xdylanm/sequencer-1/README.md

# Sequencer One

An open step sequencer platform.
