xdylanm/sequencer-1/docs/assets/images/timing_adjust_speed.pdf

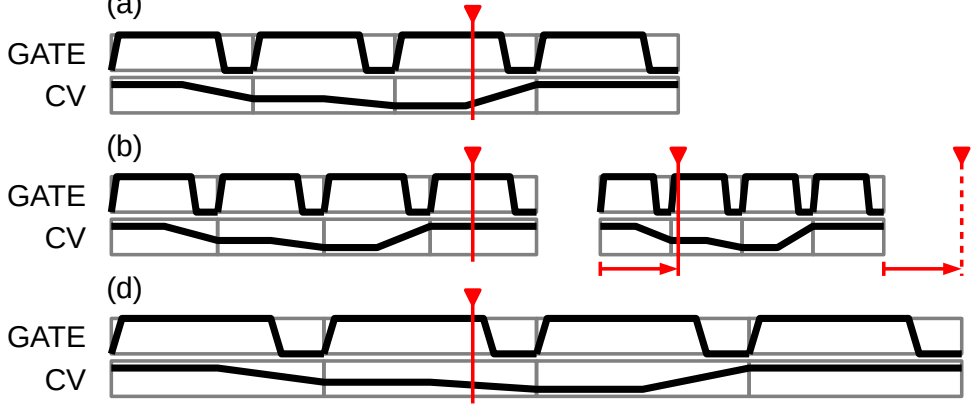
[picture p3: figure]
GATE

(a)
