xdylanm/sequencer-1/docs/assets/images/bpm_status.png

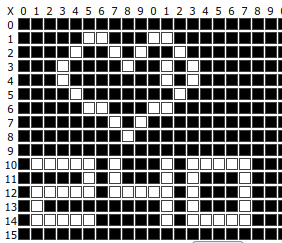
docs/assets/images/bpm_status.png
