xdylanm/sequencer-1/docs/assets/images/duty_status.png

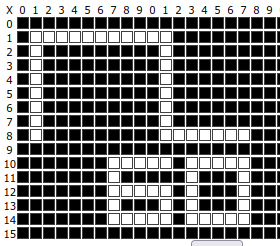
docs/assets/images/duty_status.png
