xdylanm/sequencer-1/docs/assets/images/loop_pattern.png

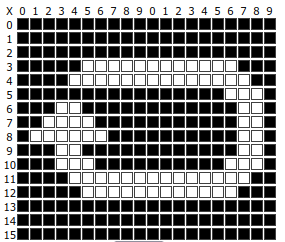
docs/assets/images/loop_pattern.png
