xdylanm/sequencer-1/docs/assets/images/pattern_quant_voct_status.png

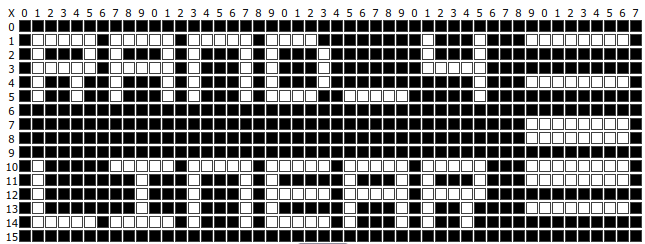
docs/assets/images/pattern_quant_voct_status.png
