xdylanm/sequencer-1/docs/assets/images/SAMD21E_AD_conversion_timing.png

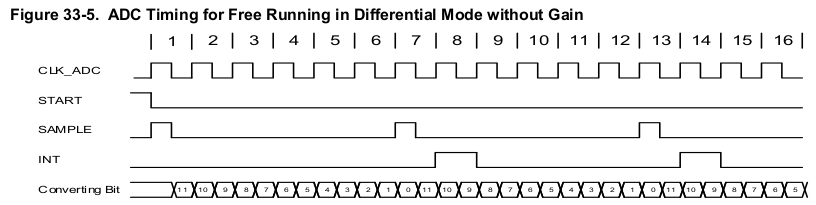
docs/assets/images/SAMD21E_AD_conversion_timing.png
