xdylanm/sequencer-1/docs/assets/images/slide_status.png

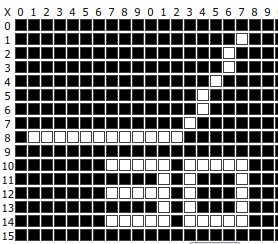
docs/assets/images/slide_status.png
