xdylanm/sequencer-1/docs/assets/images/timing_ADC_conv.png

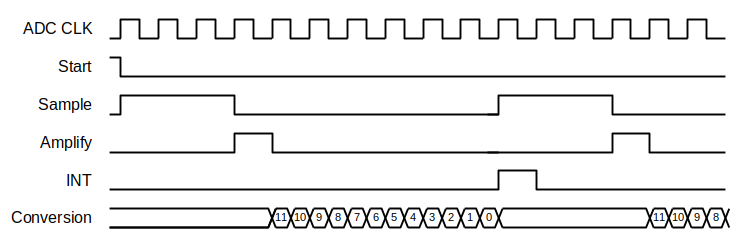
docs/assets/images/timing_ADC_conv.png
