xdylanm/sequencer-1/docs/assembly.md

# Assembly Guide

Step by step instructions for assembly

## BOM

[Download (.csv)](assets/bom.csv)

{%include-markdown "assets/bom.md"%}
