xdylanm/sequencer-1/(threads)

Thread 1 (2024-03-02):

Initial menu design

xdylanm, 2024-03-02:
Design the initial menu to control the sequencer.

- Input: rotary control with push button action
- Display: split 0.96" 128x64 OLED
  - 16 px top for status
  - 48 px bottom for menu/action
- Control
  - speed (BPM): 20-200
  - duty (%): 0-100
  - slide (%): 0-100
  - quantization: linear (none), minor, major, chromatic
  - activate: select on/off by key
    - would be preferred to have a mode button here to activate "buttons mean on/off"
  - mode: loop, bounce, random, piano
    - would be nice to have a start/stop button that could press & hold to set the current interval with a note button
  - sequence length: 1-8

xdylanm, 2024-07-13:
Done

Closed 2024-07-13.

Thread 2 (2024-03-18):

Implement core loop timing

xdylanm, 2024-03-18:
Based on the ADC conversion time (see design document for details), interleave analog mux increments and ADC reads

If read cycle
1. record level from ADC
2. record button state (debounce logic)
else
1. advance MUX address

Then
1. trigger a DA conversion
2. write GATE out
3. increment interval counter
4. calculate next state
5. update displays
6. check rotary input

xdylanm, 2024-07-13:
Done

Closed 2024-07-13.
