xdylanm/sequencer-1/hardware/seq1/seq1.kicad_pcb

## KiCad design hardware/seq1/seq1.kicad_pcb (2026-07-25)

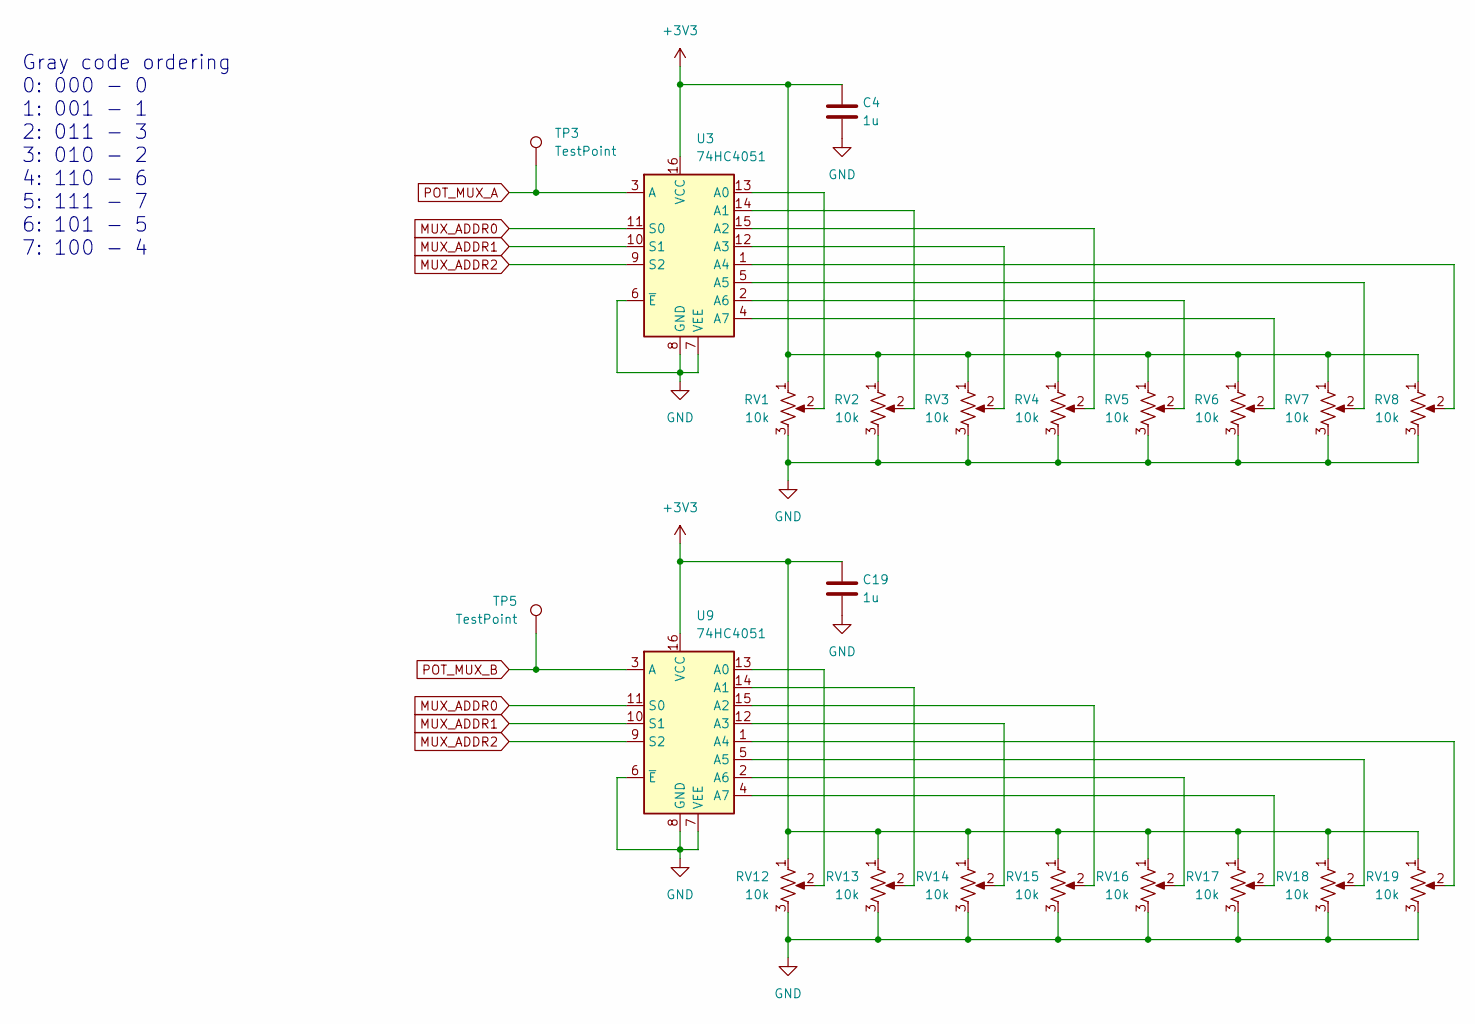
[picture p13: schematic muxdinputs.kicad_sch, Sequencer]

Parts:
C4, C19: 1u; C_Disc_D5.0mm_W2.5mm_P2.50mm
RV1, RV2, RV3, RV4, RV5, RV6, RV7, RV8, RV12, RV13, RV14, RV15, RV16, RV17, RV18, RV19: 10k; Potentiometer_Bourns_PTV09A-1_Single_Vertical
TP3, TP5: TestPoint; PinHeader_1x01_P2.54mm_Vertical
U3, U9: 74HC4051; DIP-16_W7.62mm_Socket

Connections:
+3V3: C4.1, C19.1, RV1.1, RV2.1, RV3.1, RV4.1, RV5.1, RV6.1, RV7.1, RV8.1, RV12.1, RV13.1, RV14.1, RV15.1, RV16.1, RV17.1, RV18.1, RV19.1, U3.16 (VCC), U9.16 (VCC); also elsewhere on the board
GND: C4.2, C19.2, RV1.3, RV2.3, RV3.3, RV4.3, RV5.3, RV6.3, RV7.3, RV8.3, RV12.3, RV13.3, RV14.3, RV15.3, RV16.3, RV17.3, RV18.3, RV19.3, U3.6 (~E), U3.7 (VEE), U3.8 (GND), U9.6 (~E), U9.7 (VEE), U9.8 (GND); also elsewhere on the board
MUX_ADDR0: U3.11 (S0), U9.11 (S0); also elsewhere on the board
MUX_ADDR1: U3.10 (S1), U9.10 (S1); also elsewhere on the board
MUX_ADDR2: U3.9 (S2), U9.9 (S2); also elsewhere on the board
unnamed: RV1.2, U3.13 (A0)
unnamed: RV2.2, U3.14 (A1)
unnamed: RV4.2, U3.15 (A2)
unnamed: RV3.2, U3.12 (A3)
unnamed: RV8.2, U3.1 (A4)
unnamed: RV7.2, U3.5 (A5)
unnamed: RV5.2, U3.2 (A6)
unnamed: RV6.2, U3.4 (A7)
unnamed: RV12.2, U9.13 (A0)
unnamed: RV13.2, U9.14 (A1)
unnamed: RV15.2, U9.15 (A2)
unnamed: RV14.2, U9.12 (A3)
unnamed: RV19.2, U9.1 (A4)
unnamed: RV18.2, U9.5 (A5)
unnamed: RV16.2, U9.2 (A6)
unnamed: RV17.2, U9.4 (A7)
POT_MUX_A: TP3.1, U3.3 (A); also elsewhere on the board
POT_MUX_B: TP5.1, U9.3 (A); also elsewhere on the board

Notes on the sheet:
Gray code ordering 0: 000 - 0 1: 001 - 1 2: 011 - 3 3: 010 - 2 4: 110 - 6 5: 111 - 7 6: 101 - 5 7: 100 - 4

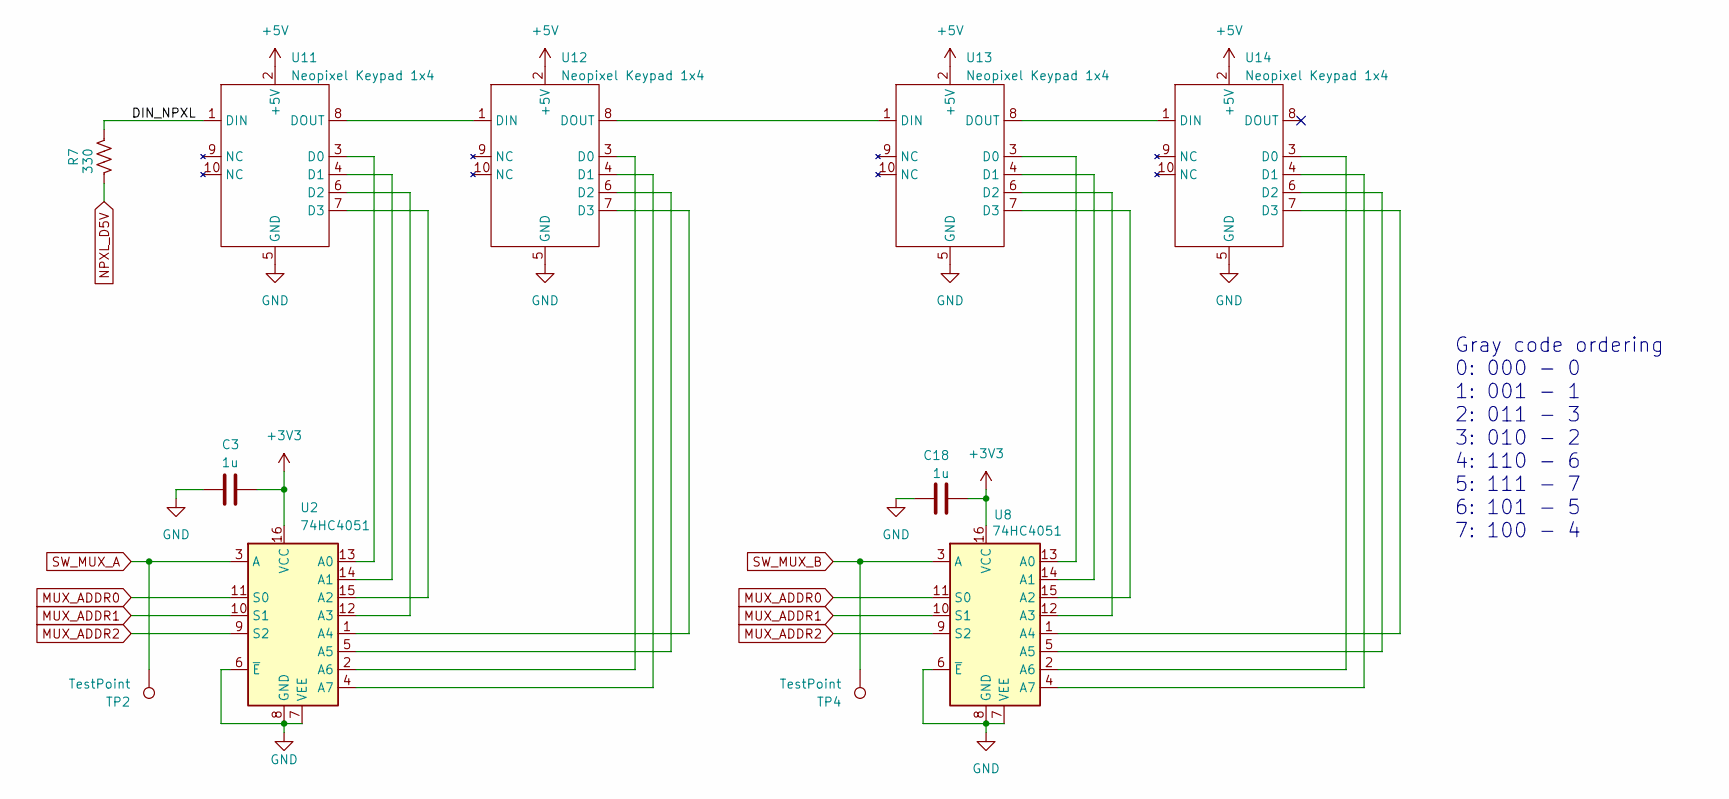
[picture p14: schematic neopxls.kicad_sch, Sequencer]

Parts:
C3, C18: 1u; C_Disc_D5.0mm_W2.5mm_P2.50mm
R7: 330; R_Axial_DIN0204_L3.6mm_D1.6mm_P2.54mm_Vertical
TP2, TP4: TestPoint; PinHeader_1x01_P2.54mm_Vertical
U2, U8: 74HC4051; DIP-16_W7.62mm_Socket
U11, U12, U13, U14: Neopixel Keypad 1x4; SW_Keypad_PushButton_1x4_Riser

Connections:
+3V3: C3.1, C18.2, U2.16 (VCC), U8.16 (VCC); also elsewhere on the board
+5V: U11.2 (+5V), U12.2 (+5V), U13.2 (+5V), U14.2 (+5V); also elsewhere on the board
/neopxls/DIN_NPXL: R7.2, U11.1 (DIN)
GND: C3.2, C18.1, U2.6 (~E), U2.7 (VEE), U2.8 (GND), U8.6 (~E), U8.7 (VEE), U8.8 (GND), U11.5 (GND), U12.5 (GND), U13.5 (GND), U14.5 (GND); also elsewhere on the board
MUX_ADDR0: U2.11 (S0), U8.11 (S0); also elsewhere on the board
MUX_ADDR1: U2.10 (S1), U8.10 (S1); also elsewhere on the board
MUX_ADDR2: U2.9 (S2), U8.9 (S2); also elsewhere on the board
NPXL_D5V: R7.1; also elsewhere on the board
unnamed: U2.13 (A0), U11.3 (D0)
unnamed: U2.14 (A1), U11.4 (D1)
unnamed: U2.12 (A3), U11.6 (D2)
unnamed: U2.15 (A2), U11.7 (D3)
unnamed: U11.8 (DOUT), U12.1 (DIN)
unnamed: U2.2 (A6), U12.3 (D0)
unnamed: U2.4 (A7), U12.4 (D1)
unnamed: U2.5 (A5), U12.6 (D2)
unnamed: U2.1 (A4), U12.7 (D3)
unnamed: U12.8 (DOUT), U13.1 (DIN)
unnamed: U8.13 (A0), U13.3 (D0)
unnamed: U8.14 (A1), U13.4 (D1)
unnamed: U8.12 (A3), U13.6 (D2)
unnamed: U8.15 (A2), U13.7 (D3)
unnamed: U13.8 (DOUT), U14.1 (DIN)
unnamed: U8.2 (A6), U14.3 (D0)
unnamed: U8.4 (A7), U14.4 (D1)
unnamed: U8.5 (A5), U14.6 (D2)
unnamed: U8.1 (A4), U14.7 (D3)
SW_MUX_A: TP2.1, U2.3 (A); also elsewhere on the board
SW_MUX_B: TP4.1, U8.3 (A); also elsewhere on the board

Notes on the sheet:
Gray code ordering 0: 000 - 0 1: 001 - 1 2: 011 - 3 3: 010 - 2 4: 110 - 6 5: 111 - 7 6: 101 - 5 7: 100 - 4

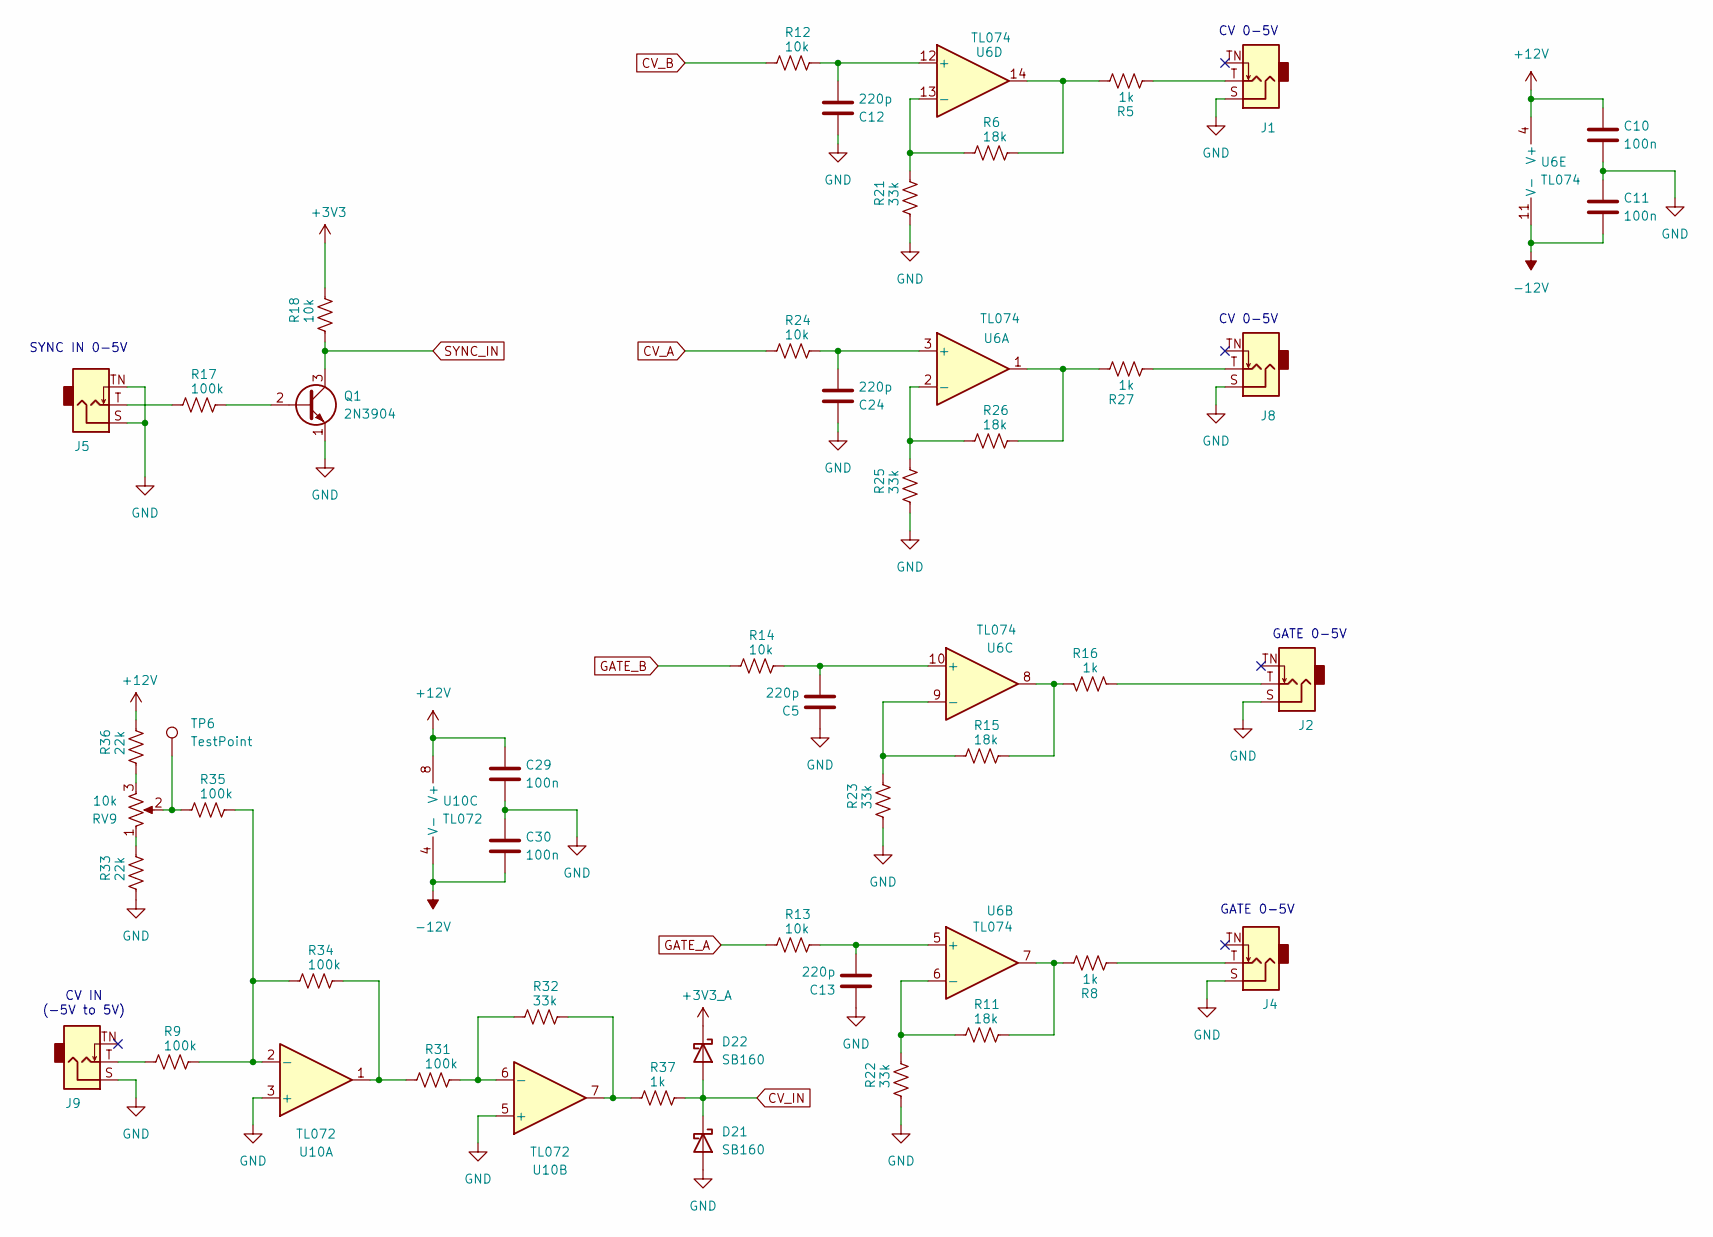
[picture p15: schematic outputs.kicad_sch, Sequencer]

Parts:
C5, C12, C13, C24: 220p; C_Disc_D5.0mm_W2.5mm_P2.50mm
C10, C11, C29, C30: 100n; C_Disc_D5.0mm_W2.5mm_P2.50mm
D21, D22: SB160; D_DO-35_SOD27_P2.54mm_Vertical_AnodeUp
J1, J2, J4, J5, J8, J9: AudioJack2_SwitchT; Jack_3.5mm_QingPu_WQP-PJ301M-12_Vertical
Q1: 2N3904; TO-92_Inline_Wide
R5, R8, R16, R37: 1k; R_Axial_DIN0204_L3.6mm_D1.6mm_P2.54mm_Vertical
R6, R11, R15, R26: 18k; R_Axial_DIN0204_L3.6mm_D1.6mm_P2.54mm_Vertical
R9, R17, R34, R35: 100k; R_Axial_DIN0204_L3.6mm_D1.6mm_P2.54mm_Vertical
R12, R18, R24: 10k; R_Axial_DIN0204_L3.6mm_D1.6mm_P2.54mm_Vertical
R13, R14: 10k; R_Axial_DIN0207_L6.3mm_D2.5mm_P10.16mm_Horizontal
R21, R22, R23, R25, R32: 33k; R_Axial_DIN0204_L3.6mm_D1.6mm_P2.54mm_Vertical
R27: 1k; R_Axial_DIN0204_L3.6mm_D1.6mm_P7.62mm_Horizontal
R31: 100k; R_Axial_DIN0204_L3.6mm_D1.6mm_P7.62mm_Horizontal
R33, R36: 22k; R_Axial_DIN0204_L3.6mm_D1.6mm_P2.54mm_Vertical
RV9: 10k; Potentiometer_Piher_PT-6-V_Vertical
TP6: TestPoint; PinHeader_1x01_P2.54mm_Vertical
U6: TL074; DIP-14_W7.62mm_Socket
U10: TL072; DIP-8_W7.62mm_Socket

Connections:
+3V3: R18.1; also elsewhere on the board
+3V3_A: D22.1 (K); also elsewhere on the board
+12V: C10.1, C29.1, R36.1, U6.4 (V+), U10.8 (V+); also elsewhere on the board
-12V: C11.2, C30.2, U6.11 (V-), U10.4 (V-); also elsewhere on the board
CV_A: R24.2; also elsewhere on the board
CV_B: R12.2; also elsewhere on the board
CV_IN: D21.1 (K), D22.2 (A), R37.1; also elsewhere on the board
GATE_A: R13.2; also elsewhere on the board
GATE_B: R14.2; also elsewhere on the board
GND: C5.1, C10.2, C11.1, C12.1, C13.1, C24.1, C29.2, C30.1, D21.2 (A), J1.S, J2.S, J4.S, J5.S, J5.TN, J8.S, J9.S, Q1.1 (E), R21.2, R22.2, R23.2, R25.2, R33.2, U10.3 (+), U10.5 (+); also elsewhere on the board
unnamed: J1.T, R5.2
unnamed: J2.T, R16.2
unnamed: J4.T, R8.2
unnamed: J5.T, R17.2
unnamed: J8.T, R27.2
unnamed: J9.T, R9.2
unnamed: Q1.2 (B), R17.1
unnamed: R5.1, R6.1, U6.14
unnamed: R8.1, R11.1, U6.7
unnamed: R15.1, R16.1, U6.8
unnamed: R26.1, R27.1, U6.1
unnamed: R31.2, R34.1, U10.1
unnamed: R32.1, R37.2, U10.7
unnamed: R33.1, RV9.1
unnamed: R35.2, RV9.2, TP6.1
unnamed: R36.2, RV9.3
unnamed: C24.2, R24.1, U6.3 (+)
unnamed: R25.1, R26.2, U6.2 (-)
unnamed: C13.2, R13.1, U6.5 (+)
unnamed: R11.2, R22.1, U6.6 (-)
unnamed: C5.2, R14.1, U6.10 (+)
unnamed: R15.2, R23.1, U6.9 (-)
unnamed: C12.2, R12.1, U6.12 (+)
unnamed: R6.2, R21.1, U6.13 (-)
unnamed: R9.1, R34.2, R35.1, U10.2 (-)
unnamed: R31.1, R32.2, U10.6 (-)
SYNC_IN: Q1.3 (C), R18.2; also elsewhere on the board

Notes on the sheet:
SYNC IN 0-5V
CV IN (-5V to 5V)
GATE 0-5V
CV 0-5V

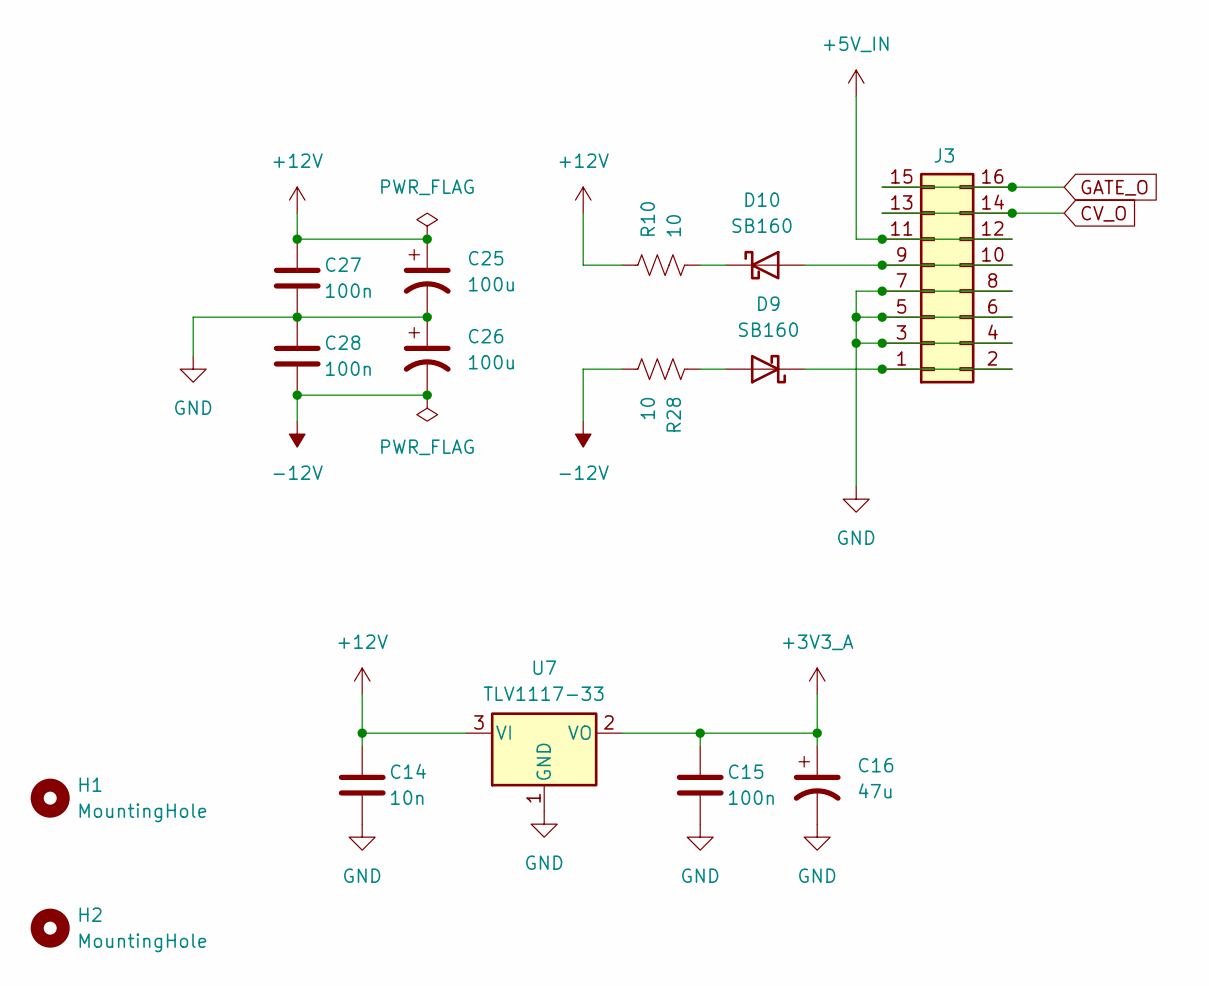
[picture p16: schematic pwr.kicad_sch, Sequencer]

Parts:
C14: 10n; C_Disc_D5.0mm_W2.5mm_P2.50mm
C15, C27, C28: 100n; C_Disc_D5.0mm_W2.5mm_P2.50mm
C16: 47u; CP_Radial_D5.0mm_P2.50mm
C25, C26: 100u; CP_Radial_D6.3mm_P2.50mm
D9, D10: SB160; D_DO-35_SOD27_P2.54mm_Vertical_AnodeUp
H1, H2: MountingHole; MountingHole_3.2mm_M3_DIN965
J3: Conn_02x08_Odd_Even; IDC-Header_2x08_P2.54mm_Vertical
R10: 10; R_Axial_DIN0204_L3.6mm_D1.6mm_P2.54mm_Vertical
R28: 10; R_Axial_DIN0207_L6.3mm_D2.5mm_P7.62mm_Horizontal
U7: TLV1117-33; SOT-223-3_TabPin2

Connections:
+3V3_A: C15.1, C16.1, U7.2 (VO); also elsewhere on the board
+5V_IN: J3.11, J3.12; also elsewhere on the board
+12V: C14.1, C25.1, C27.1, R10.1, U7.3 (VI); also elsewhere on the board
-12V: C26.2, C28.2, R28.2; also elsewhere on the board
CV_O: J3.13, J3.14
GATE_O: J3.15, J3.16
GND: C14.2, C15.2, C16.2, C25.2, C26.1, C27.2, C28.1, J3.3, J3.4, J3.5, J3.6, J3.7, J3.8, U7.1 (GND); also elsewhere on the board
unnamed: D9.2 (A), R28.1
unnamed: D9.1 (K), J3.1, J3.2
unnamed: D10.2 (A), J3.9, J3.10
unnamed: D10.1 (K), R10.2

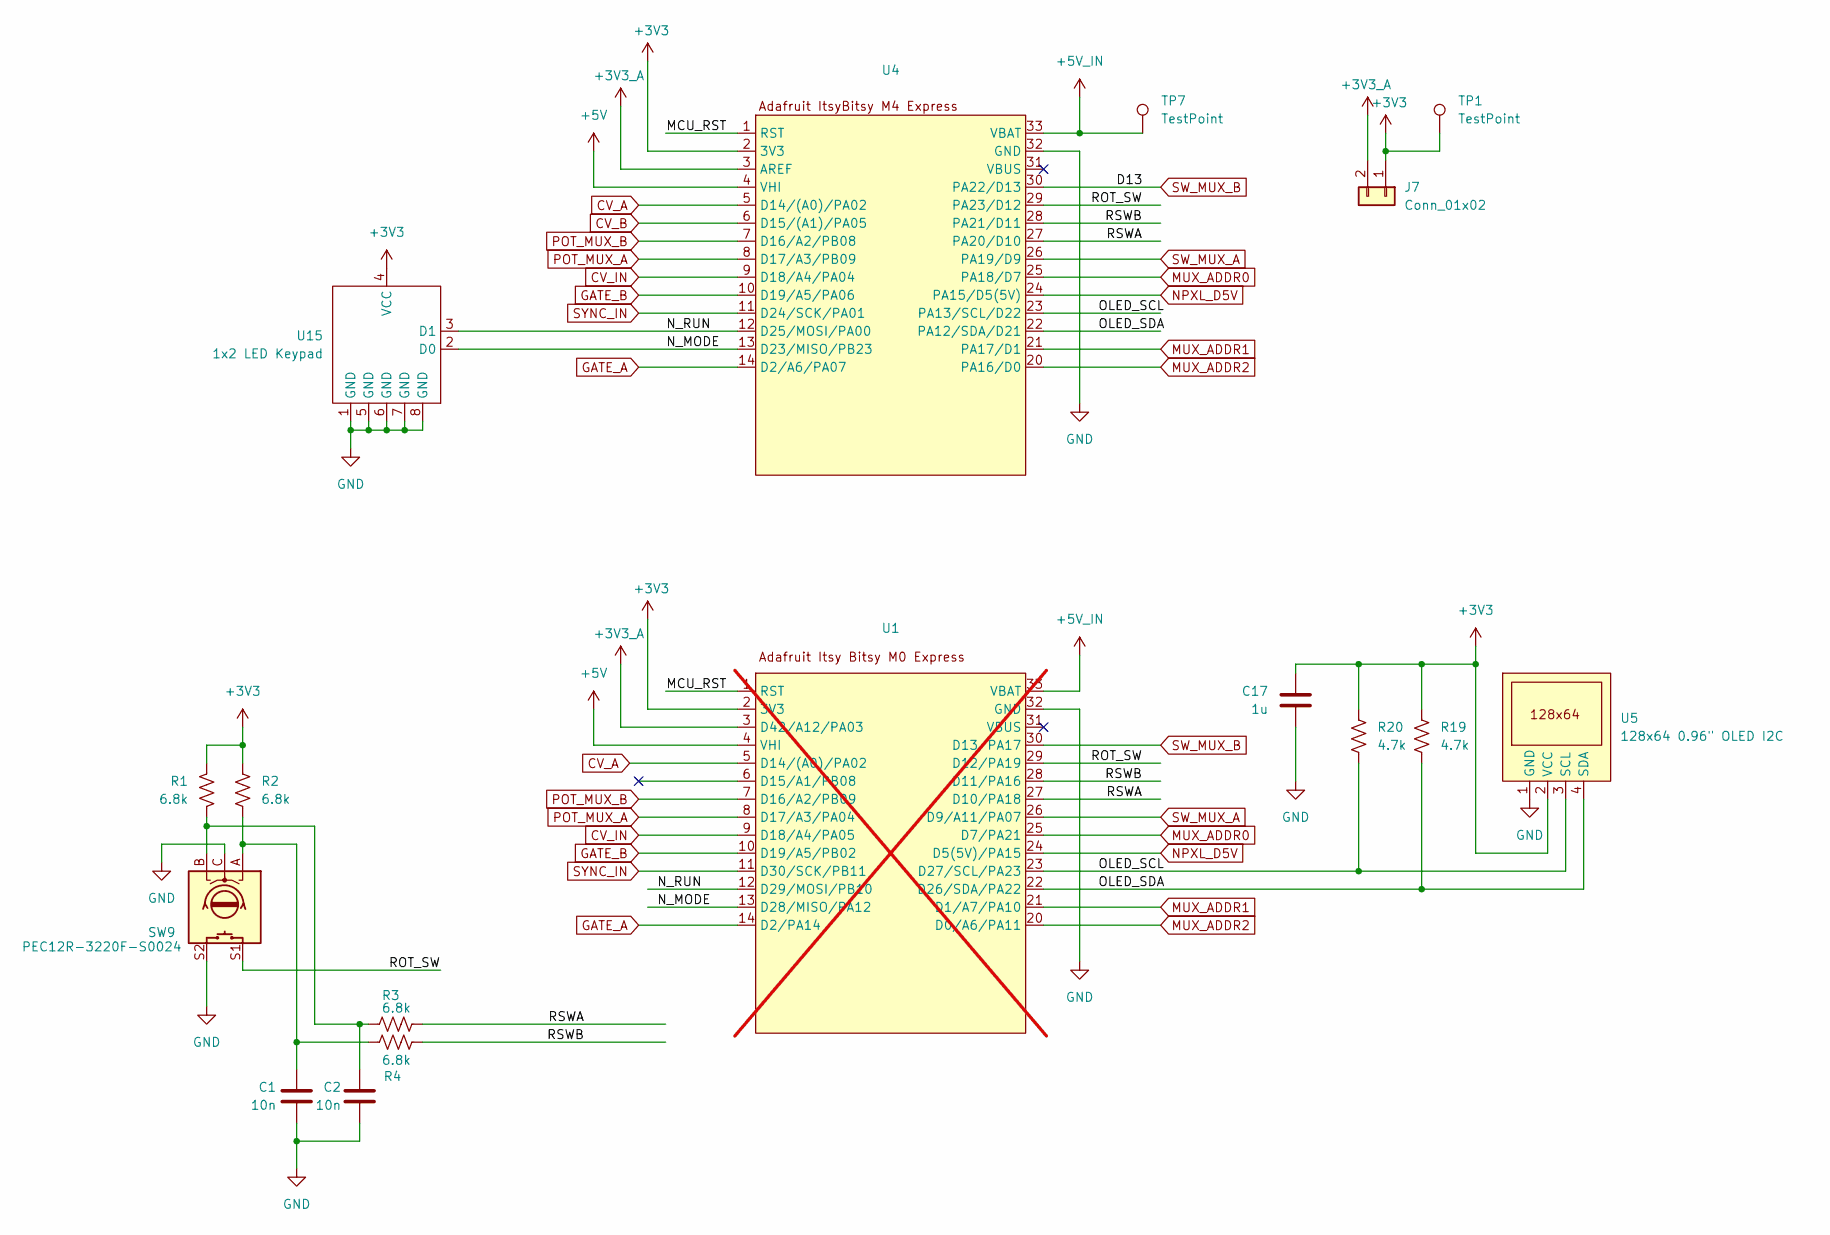
[picture p17: schematic mcu.kicad_sch, Sequencer]

Parts:
C1, C2: 10n; C_Disc_D5.0mm_W2.5mm_P2.50mm
C17: 1u; C_Disc_D5.0mm_W2.5mm_P2.50mm
J7: Conn_01x02; PinHeader_1x02_P2.54mm_Vertical
R1, R2, R3, R4: 6.8k; R_Axial_DIN0204_L3.6mm_D1.6mm_P2.54mm_Vertical
R19, R20: 4.7k; R_Axial_DIN0204_L3.6mm_D1.6mm_P2.54mm_Vertical
SW9: PEC12R-3220F-S0024; RotaryEncoder_Bourns_Vertical_PEC12R-3x17F-Sxxxx
TP1, TP7: TestPoint; PinHeader_1x01_P2.54mm_Vertical
U1: Adafruit_ItsyBitsy_M0_Express_DIP; not fitted
U4: Adafruit_ItsyBitsy_M0_Express_DIP
U5: 128x64 0.96" OLED I2C; OLED_0.96in_SSD1306_I2C
U15: 1x2 LED Keypad; SW_Keypad_PushButton_1x2_Riser

Connections:
+3V3: C17.1, J7.1, R1.1, R2.1, R19.1, R20.1, TP1.1, U1.2 (3V3), U4.2 (3V3), U5.2 (VCC), U15.4 (VCC); also elsewhere on the board
+3V3_A: J7.2, U1.3 (D42/A12/PA03), U4.3 (AREF); also elsewhere on the board
+5V: U1.4 (VHI), U4.4 (VHI); also elsewhere on the board
+5V_IN: TP7.1, U1.33 (VBAT), U4.33 (VBAT); also elsewhere on the board
/mcu/MCU_RST: U1.1 (RST), U4.1 (RST)
/mcu/N_MODE: U1.13 (D28/MISO/PA12), U4.13 (D23/MISO/PB23), U15.2 (D0)
/mcu/N_RUN: U1.12 (D29/MOSI/PB10), U4.12 (D25/MOSI/PA00), U15.3 (D1)
/mcu/OLED_SCL: R20.2, U1.23 (D27/SCL/PA23), U4.23 (PA13/SCL/D22), U5.3 (SCL)
/mcu/OLED_SDA: R19.2, U1.22 (D26/SDA/PA22), U4.22 (PA12/SDA/D21), U5.4 (SDA)
/mcu/ROT_SW: SW9.S1, U1.29 (D12/PA19), U4.29 (PA23/D12)
/mcu/RSWA: R3.1, U1.27 (D10/PA18), U4.27 (PA20/D10)
/mcu/RSWB: R4.1, U1.28 (D11/PA16), U4.28 (PA21/D11)
CV_A: U1.5 (D14/(A0)/PA02), U4.5 (D14/(A0)/PA02); also elsewhere on the board
CV_B: U4.6 (D15/(A1)/PA05); also elsewhere on the board
CV_IN: U1.9 (D18/A4/PA05), U4.9 (D18/A4/PA04); also elsewhere on the board
GATE_A: U1.14 (D2/PA14), U4.14 (D2/A6/PA07); also elsewhere on the board
GATE_B: U1.10 (D19/A5/PB02), U4.10 (D19/A5/PA06); also elsewhere on the board
GND: C1.2, C2.2, C17.2, SW9.C, SW9.S2, U1.32 (GND), U4.32 (GND), U5.1 (GND), U15.1 (GND), U15.5 (GND), U15.6 (GND), U15.7 (GND), U15.8 (GND); also elsewhere on the board
MUX_ADDR0: U1.25 (D7/PA21), U4.25 (PA18/D7); also elsewhere on the board
MUX_ADDR1: U1.21 (D1/A7/PA10), U4.21 (PA17/D1); also elsewhere on the board
MUX_ADDR2: U1.20 (D0/A6/PA11), U4.20 (PA16/D0); also elsewhere on the board
NPXL_D5V: U1.24 (D5(5V)/PA15), U4.24 (PA15/D5(5V)); also elsewhere on the board
unnamed: C1.1, R2.2, R4.2, SW9.A
unnamed: C2.1, R1.2, R3.2, SW9.B
POT_MUX_A: U1.8 (D17/A3/PA04), U4.8 (D17/A3/PB09); also elsewhere on the board
POT_MUX_B: U1.7 (D16/A2/PB09), U4.7 (D16/A2/PB08); also elsewhere on the board
SW_MUX_A: U1.26 (D9/A11/PA07), U4.26 (PA19/D9); also elsewhere on the board
SW_MUX_B: U1.30 (D13/PA17), U4.30 (PA22/D13); also elsewhere on the board
SYNC_IN: U1.11 (D30/SCK/PB11), U4.11 (D24/SCK/PA01); also elsewhere on the board

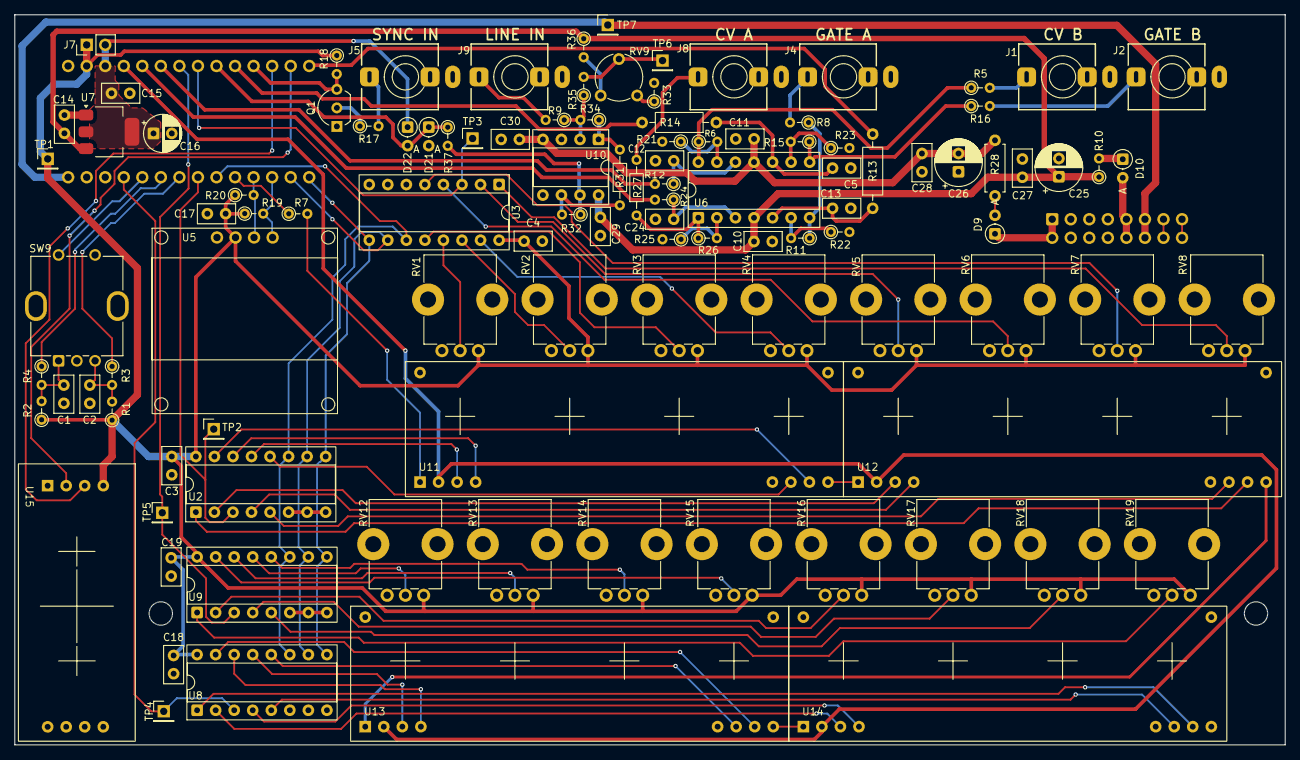
[picture p18: board seq1.kicad_pcb from above]

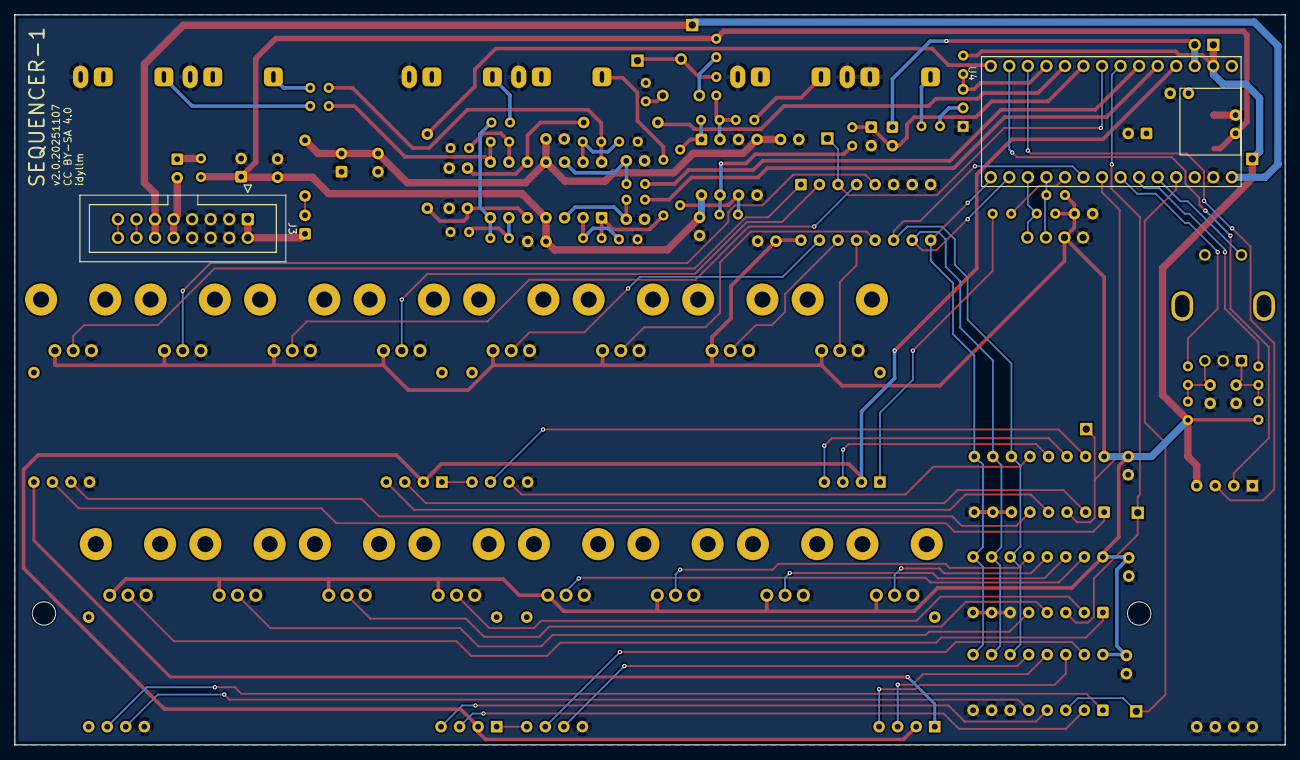
[picture p19: board seq1.kicad_pcb from below]

Board: 2 copper layers, 174.0 x 100.0 mm, 111 parts (2 on the bottom side), 98 nets.
