xdylanm/sequencer-1/hardware/keypad_1x4/keypad_1x4.kicad_pcb

## KiCad design hardware/keypad_1x4/keypad_1x4.kicad_pcb (2025-11-07)

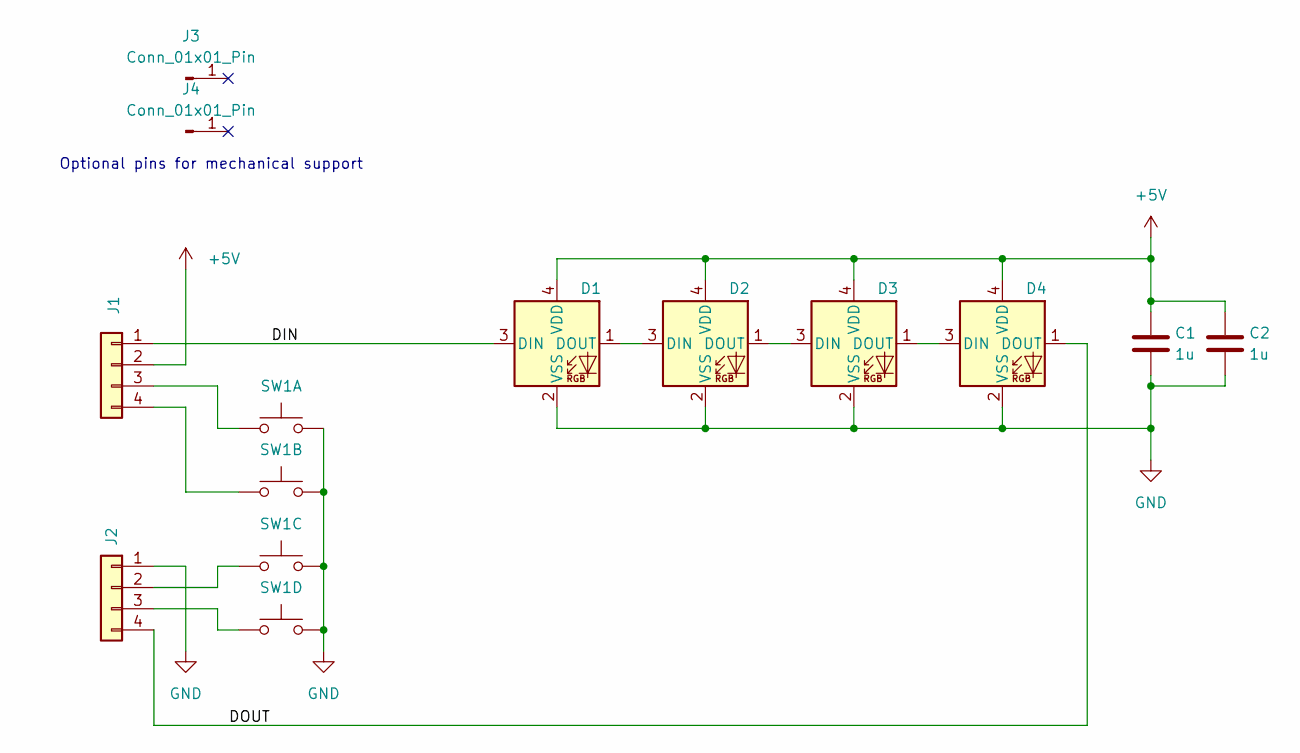
[picture p20: schematic keypad_1x4.kicad_sch, 1x4 Neopixel Illuminated Keypad]

Parts:
C1, C2: 1u; C_Disc_D5.0mm_W2.5mm_P5.00mm
D1, D2, D3, D4: SK6805; LED_SK6805_PLCC4_2.4x2.7mm_P1.3mm
J1, J2: Conn_01x04; PinHeader_1x04_P2.54mm_Vertical
J3, J4: Conn_01x01_Pin; PinHeader_1x01_P2.54mm_Vertical
SW1: SW_Push_x4; SW_Silicone_Keypad_PushButton_10mm_4x1grid_NH

Connections:
+5V: C1.1, C2.1, D1.4 (VDD), D2.4 (VDD), D3.4 (VDD), D4.4 (VDD), J1.2
/DIN: D1.3 (DIN), J1.1
/DOUT: D4.1 (DOUT), J2.4
GND: C1.2, C2.2, D1.2 (VSS), D2.2 (VSS), D3.2 (VSS), D4.2 (VSS), J2.1, SW1.1, SW1.3, SW1.5, SW1.7
unnamed: D1.1 (DOUT), D2.3 (DIN)
unnamed: D2.1 (DOUT), D3.3 (DIN)
unnamed: D3.1 (DOUT), D4.3 (DIN)
unnamed: J1.3, SW1.2
unnamed: J1.4, SW1.4
unnamed: J2.2, SW1.6
unnamed: J2.3, SW1.8

Notes on the sheet:
Optional pins for mechanical support

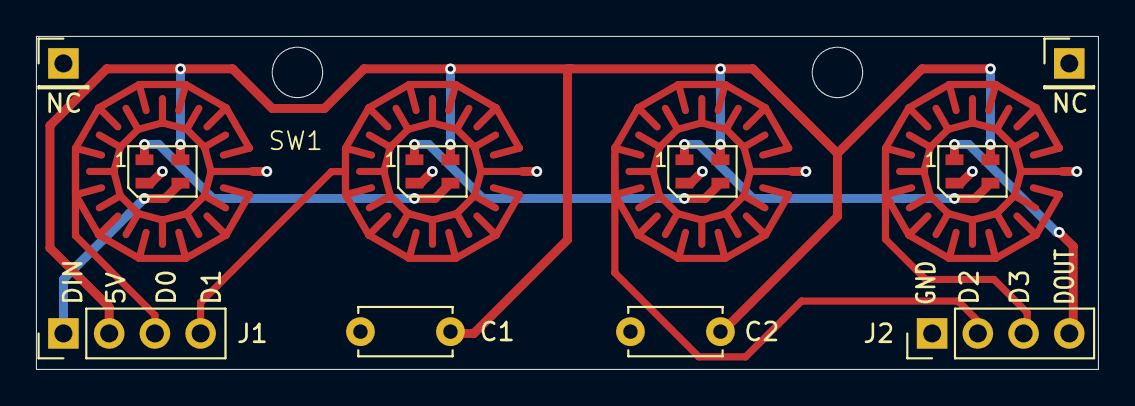
[picture p21: board keypad_1x4.kicad_pcb from above]

Board: 2 copper layers, 59.0 x 18.5 mm, 11 parts (0 on the bottom side), 11 nets.
