xdylanm/sequencer-1/hardware/keypad_1x2/keypad_1x2.kicad_pcb

## KiCad design hardware/keypad_1x2/keypad_1x2.kicad_pcb (2025-11-07)

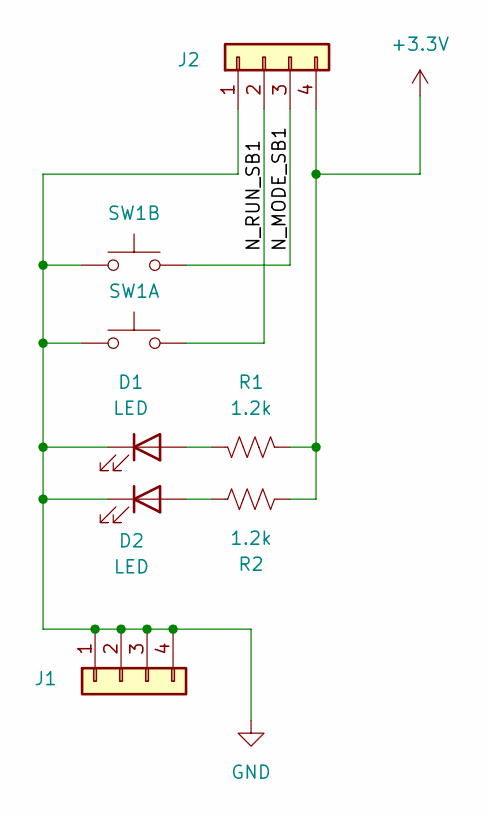
[picture p22: schematic keypad_1x2.kicad_sch, 1x2 LED Illuminated Keypad]

Parts:
D1, D2: LED; LED_3mm_Backside_SMD
J1, J2: Conn_01x04; PinHeader_1x04_P2.54mm_Vertical
R1, R2: 1.2k; R_Axial_DIN0204_L3.6mm_D1.6mm_P2.54mm_Vertical
SW1: SW_Push_x2; SW_Silicone_Keypad_PushButton_10mm_2x1grid_NH

Connections:
+3.3V: J2.4, R1.2, R2.2
/N_MODE_SB1: J2.3, SW1.4
/N_RUN_SB1: J2.2, SW1.2
GND: D1.1 (K), D2.1 (K), J1.1, J1.2, J1.3, J1.4, J2.1, SW1.1, SW1.3
unnamed: D1.2 (A), R1.1
unnamed: D2.2 (A), R2.1

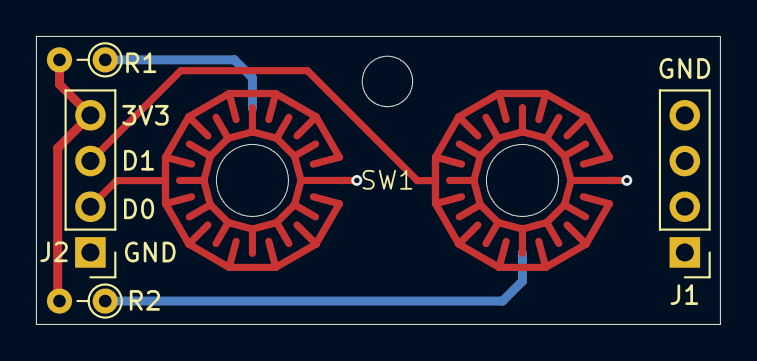
[picture p23: board keypad_1x2.kicad_pcb from above]

Board: 2 copper layers, 38.0 x 16.0 mm, 7 parts (0 on the bottom side), 6 nets.
