xdylanm/sequencer-1/firmware/sequencer/glyphs.h

#ifndef glyphs_h_
#define glyphs_h_

#include <Arduino.h>

namespace seq
{

// WxH = 19x10
static uint8_t const bpm_heart[] = {
    0x00, 0x00, 0x00, 0x03, 0x18, 0x00, 0x04, 0xa4, 
    0x00, 0x08, 0x4a, 0x00, 0x08, 0x0a, 0x00, 0x04, 
    0x04, 0x00, 0x03, 0x18, 0x00, 0x00, 0xa0, 0x00, 
    0x00, 0x40, 0x00, 0x00, 0x00, 0x00};

// WxH = 19x9
static uint8_t const pattern_loop[] = {
    0x00, 0x00, 0x00, 0x1f, 0xff, 0x80, 0x00, 0x00, 
    0xc0, 0x10, 0x00, 0x40, 0x38, 0x00, 0x40, 0x54, 
    0x00, 0x40, 0x10, 0x00, 0xc0, 0x0f, 0xff, 0x80, 
    0x00, 0x00, 0x00};

// WxH = 19x9
static uint8_t const pattern_bounce[] = {
    0x00, 0x00, 0x00, 0x00, 0x00, 0x00, 0x10, 0x01, 
    0x00, 0x20, 0x00, 0x80, 0x7f, 0xff, 0xc0, 0x20, 
    0x00, 0x80, 0x10, 0x01, 0x00, 0x00, 0x00, 0x00, 
    0x00, 0x00, 0x00};

// WxH = 19x9
static uint8_t const pattern_rand[] = {
    0x00, 0x00, 0x00, 0x1f, 0xe4, 0x00, 0x08, 0x4c, 
    0x00, 0x09, 0x94, 0x00, 0x06, 0x25, 0xc0, 0x0c, 
    0x44, 0xc0, 0x12, 0x85, 0x40, 0x63, 0x06, 0x00, 
    0x00, 0x00, 0x00};

}

#endif
