xdylanm/sequencer-1/(commit log)

2023-09-20 initial prototype firmware for i2c OLED display and rotary encoder
2024-03-18 adding initial rev of schematic
    [seq1.kicad_pcb, seq1.kicad_sch]
2024-03-22 firmware draft for sequencer, tested buttons and pots through the muxes, verified ADC config
    [seq1-alt-mcu.kicad_sch, seq1.kicad_sch]
2024-03-24 updates to schematic/layout (started layout). Added glyph and display class to manage and show status (PoC)
    [seq1-alt-mcu.kicad_sch, seq1.kicad_pcb, seq1.kicad_sch]
2024-04-08 menu system and adjustment through the physical interface
    [mcu.kicad_sch, muxdinputs.kicad_sch, neopxls.kicad_sch, outputs.kicad_sch, pwr.kicad_sch, seq1.kicad_pcb, seq1.kicad_sch]
2024-04-08 Updates to menu and controller refactoring into machine state, added display for mode select state (issue #3)
    [controller.cpp, controller.h, machinestate.cpp, machinestate.h, seqdisplay.cpp, seqdisplay.h, sequencer.ino]
2024-04-15 schematic and layout for v1 board
    [mcu.kicad_sch, muxdinputs.kicad_sch, neopxls.kicad_sch, outputs.kicad_sch, pwr.kicad_sch, seq1.kicad_pcb]
2024-04-15 layout clean up
    [pwr.kicad_sch, seq1.kicad_pcb]
2024-05-05 v1 board
    [muxdinputs.kicad_sch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]
2024-07-06 Adding support for the Itsy Bitsy M4 (SAMD51) architecture. Removed _util code and refactored to use the SAMD Utilities Library (SAMD_Utils.h). Compiles for QT Py M0, Itsy Bitsy M0 and M4
    [mcu.kicad_sch, muxdinputs.kicad_sch, neopxls.kicad_sch, outputs.kicad_sch, pwr.kicad_sch, seq1.kicad_sch]
2024-07-07 fixing bugs in pin definitions
    [pin_definitions.h, sequencer.ino]
2024-07-07 bug in layout: order of pots reversed. Fixes for slide algo in controller, pin definitions and other fixes found in testing
    [mcu.kicad_sch, seq1.kicad_pcb]
2024-10-15 updating the board with new line in
    [mcu.kicad_sch, muxdinputs.kicad_sch, neopxls.kicad_sch, outputs.kicad_sch, pwr.kicad_sch, seq1.kicad_pcb, seq1.kicad_sch]
2025-11-07 layout for v2 board (WIP) with risers part of same schematic/PBC
    [mcu.kicad_sch, muxdinputs.kicad_sch, neopxls.kicad_sch, outputs.kicad_sch, pwr.kicad_sch, seq1.kicad_pcb, seq1.kicad_sch]
2025-11-07 moved 1x4 keypad to separate project
    [keypad_1x4.kicad_pcb, keypad_1x4.kicad_sch, neopxls.kicad_sch, seq1.kicad_pcb]
2025-11-07 Adding 1x2 LED illuminated keypad, updates to 1x4 board for gbrs
    [keypad_1x2.kicad_pcb, keypad_1x2.kicad_sch, keypad_1x4.kicad_pcb, keypad_1x4.kicad_sch]
2025-11-07 tweaks to PCB layout from grb review
    [keypad_1x4.kicad_pcb]
2025-11-07 updated schematic title blocks for v2, generated gerbers
    [mcu.kicad_sch, muxdinputs.kicad_sch, neopxls.kicad_sch, outputs.kicad_sch, pwr.kicad_sch, seq1.kicad_pcb, seq1.kicad_sch]
2025-12-05 Updated docs for mkdocs conversion (WIP)
    [seq1-B_Cu.gbl, seq1-B_Mask.gbs, seq1-B_Paste.gbp, seq1-B_Silkscreen.gbo, seq1-Edge_Cuts.gm1, seq1-F_Cu.gtl, seq1-F_Mask.gts, seq1-F_Paste.gtp]
2026-07-25 Some schematic cleanup
    [keypad_1x4.kicad_sch, mcu.kicad_sch, muxdinputs.kicad_sch, neopxls.kicad_sch, outputs.kicad_sch, pwr.kicad_sch, seq1.kicad_pcb, seq1.kicad_sch]
