xdylanm/sequencer-1/(notices)

Notices in the files:
hardware/keypad_1x2/keypad_1x2.kicad_sch:
CC BY-SA 4.0
hardware/keypad_1x4/keypad_1x4.kicad_pcb:
idyllm CC BY-SA 4.0
